MirkoRima/ProgettoDispositivo_Tesi/README.md

# ProgettoDispositivo_Tesi

Questa repository contiene la relazione e i codici per il progetto di tesi:
"Progettazione di un sistema di acquisizione di immagini in ambiente controllato"

Sono presenti i seguenti programmi:

- comunicaFinale.py (Programma principale da avviare sulla Jetson);
- acquisizione.ino (Programma da caricare su un Arduino uno per la parte di acquisizione);
- gestioneLuci.ino (Programma da caricare su un altro Arduino uno per la parte di gestione delle luci).

Inoltre si trovano anche i programmi scritti dai miei due colleghi:

- E.py (per la parte di preprocessing, scritto da Francesco Prete);
- pointCloud.py (per la parte di ricostruzione del modello 3D, scritto da Samuele Ventura);
- functions.py (che viene richiamato da pointCloud.py, scritto da Samuele Ventura).

Sono presenti due cartelle con i codici adattati per la:

- Jetson TK1;
- Jetson TX1.

Relazione: Mirko Rima thesis.pdf
